zcsxll/zx_solder_paste_elf/README.md

# zx_solder_paste_elf

bilibili：https://www.bilibili.com/video/BV16M411r7NK/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

硬件设计参考了工科男孙老师的
https://www.bilibili.com/video/BV1Fd4y1F7oQ/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

感谢孙老师！

详细说明 --> 说明.docx
