zcsxll/zx_solder_paste_elf/说明.docx

目录

## 致谢

硬件设计参考了工科男孙老师的

https://www.bilibili.com/video/BV1Fd4y1F7oQ/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

感谢孙老师！

使用了同款N20电机，锂电池充放电方案和电机驱动方案也一样。

主要区别是单片机使用STM32，固定锡膏针筒使用PCB组成的卡扣。

# 硬件

## 开发环境

立创EDA标准版

## 文件说明

PCB_solder_paste_elf.json PCB文件

solder_paste_elf.json 原理图

stents_35g_1.json 卡扣（需要根据自己的锡膏尺寸修改，我用的是35g的）

stents_35g_2.json 同上

## 螺丝

用了两种。

固定N20和卡扣，使用的是M1.6，长度4毫米，略长~

另外一种是M3螺丝和铜柱，长度需要根据锡膏容量选择，因为上述N20电机的丝杆长度是固定的

## 垫片

用的是如下图：

5*3.2*3的意思是外直径5毫米，内直径3.2毫米，高度3毫米

# 软件

## 开发环境

Keil 5.27和cubeMX。

控制电机使用了2个通道的PWM，读取电机的编码器使用了STM32定时器的Encoder模式。电机转动的圈数采用位置式PID控制，PID参数没有细调，整个系统不需要特别精确。

# 卡扣安装

一共两种卡扣PCB，卡扣A（下图左）和卡扣B（下图右）。

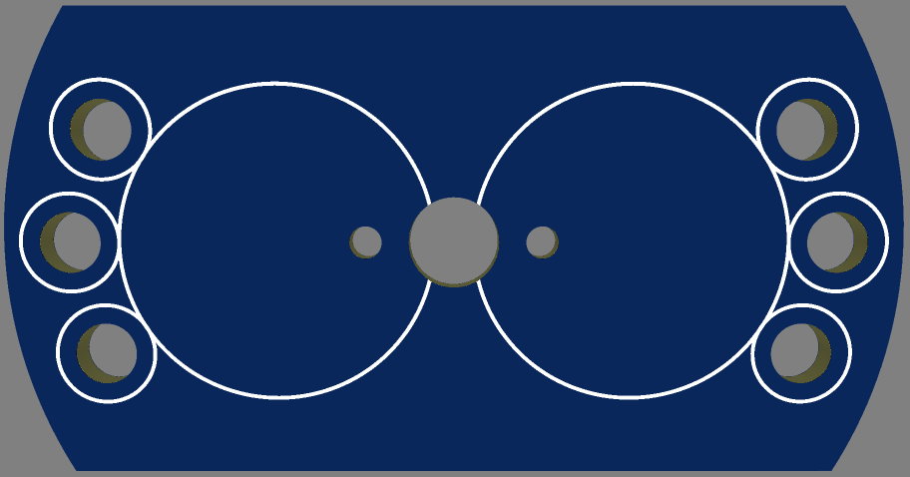
[picture p1: figure]
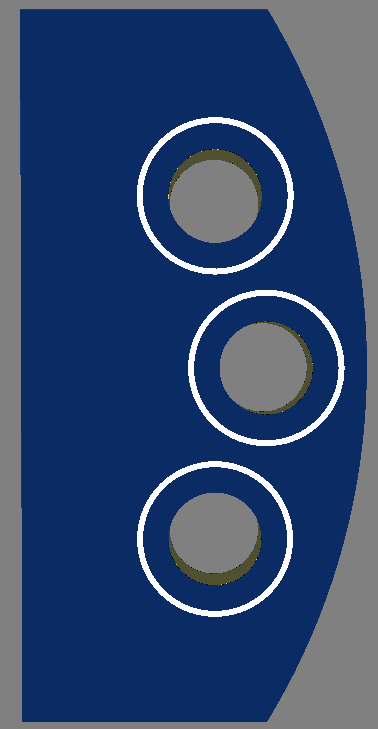
[picture p2: figure]

1. 固定N20电机和卡扣A，使用两个M1.6*3螺丝，两个螺丝孔如下图所指

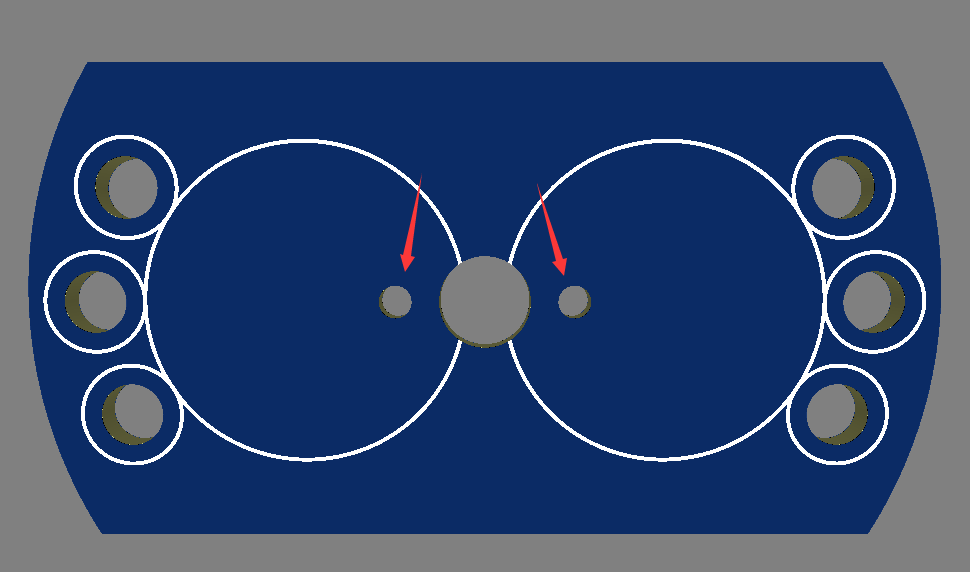
[picture p3: figure]
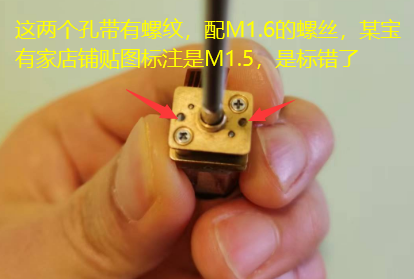
[picture p4: figure]

2. 根据丝杆长度以及锡膏容量的关系，选择6个合适长度的双通M3铜柱，做下图位置的连接。

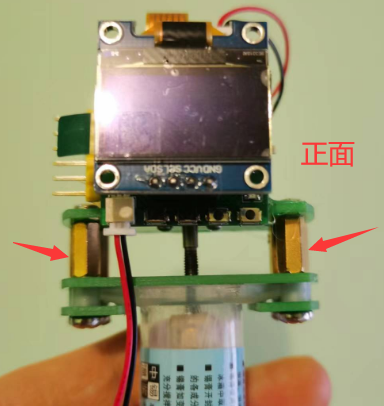
[picture p5: figure]
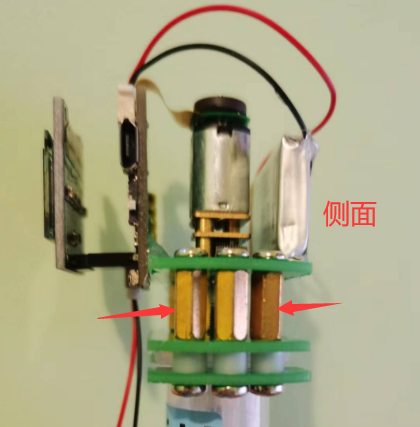
[picture p6: figure]

3. 使用6个5*3.2*3的垫片和6个M3螺丝，固定卡扣B，如下图红框中的部分

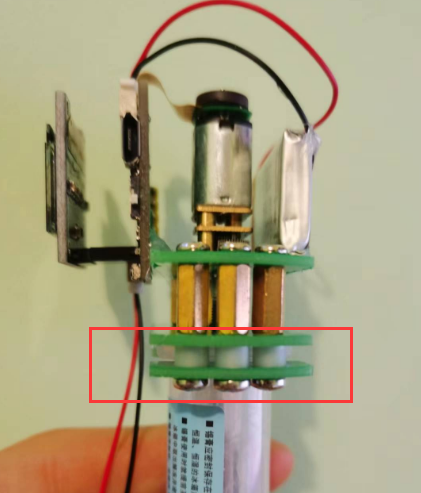
[picture p7: figure]
