zcsxll/zx_solder_paste_elf/(list of files, drawings)

Other design files:
hardware/PCB_solder_paste_elf.json
