zcsxll/zx_solder_paste_elf/software/STM32F042F6P6/Core/Src/main.c

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
/* Includes ------------------------------------------------------------------*/
#include "main.h"
#include "i2c.h"
#include "tim.h"
#include "gpio.h"

/* USER CODE BEGIN Includes */

#include <stdio.h>
#include "pos_pid.h"
#include "oled_096.h"

/* USER CODE END Includes */


/* USER CODE BEGIN PV */

uint8_t mode = 0;
uint16_t target = 200;
uint16_t speed = 700;
uint8_t done = 1;

/* USER CODE END PV */

void SystemClock_Config(void);
/* USER CODE BEGIN 0 */

#define PA0_SET	GPIOA->BSRR = GPIO_PIN_0
#define PA0_CLR	GPIOA->BRR = GPIO_PIN_0

/*int fputc(int ch, FILE *f) {
    HAL_UART_Transmit(&huart2, (uint8_t*)&ch, 1, 10);
    return (ch);
}*/

void HAL_TIM_PeriodElapsedCallback(TIM_HandleTypeDef *htim) {
    int16_t count = (int16_t)htim3.Instance->CNT;
    int16_t out = pos_pid_update(count);
    if(out == 0) {
        htim2.Instance->CCR1 = 0;
        htim2.Instance->CCR2 = 0;
		HAL_TIM_Base_Stop_IT(&htim17);
		done = 1;
    } else {
        htim2.Instance->CCR1 = 1000 - out;
        htim2.Instance->CCR2 = 1000;
    }
    //printf("%d %d\r\n", count, out);
}

uint8_t read_key() {
    uint8_t ret = 0;
    if((GPIOA->IDR & GPIO_PIN_4) == 0) {
        ret |= 1;
    }
    if((GPIOA->IDR & GPIO_PIN_3) == 0) {
        ret |= 2;
    }
    if((GPIOA->IDR & GPIO_PIN_2) == 0) {
        ret |= 4;
    }
    if((GPIOA->IDR & GPIO_PIN_5) == 0) {
        ret |= 8;
    }
    return ret;
}

void show_target() {
	static char buf[16];
	sprintf(buf, "target: %4d", target);
	oled_paint_string(&hi2c1, 16, 4, buf);
}

void show_speed() {
	static char buf[16];
	sprintf(buf, " speed: %4d", speed);
	oled_paint_string(&hi2c1, 16, 4, buf);
}

void show_mode_info() {
    if(mode == 0) {
        oled_paint_hz(&hi2c1, 32 + 0, 2, 0);
        oled_paint_hz(&hi2c1, 32 + 16, 2, 1);
        oled_paint_hz(&hi2c1, 32 + 32, 2, 2);
        oled_paint_hz(&hi2c1, 32 + 48, 2, 3);
        show_target();
    } else if (mode == 1) {
        oled_paint_hz(&hi2c1, 32 + 0, 2, 4);
        oled_paint_hz(&hi2c1, 32 + 16, 2, 5);
        oled_paint_hz(&hi2c1, 32 + 32, 2, 2);
        oled_paint_hz(&hi2c1, 32 + 48, 2, 3);
        show_speed();
		oled_paint_string(&hi2c1, 72, 6, "     ");
    } else if (mode == 2) {
		oled_paint_hz(&hi2c1, 32 + 0, 2, 6);
        oled_paint_hz(&hi2c1, 32 + 16, 2, 7);
        oled_paint_hz(&hi2c1, 32 + 32, 2, 2);
        oled_paint_hz(&hi2c1, 32 + 48, 2, 3);
        show_speed();
		oled_paint_string(&hi2c1, 72, 6, "     ");
	}
}

void adjust_target_or_speed(uint8_t key) {
	if (mode == 0) {
		if (key == 2) {
			target = target < 2000 ? target + 100 : 2000;
		} else {
			target = target > 100 ? target - 100 : 100;
		}
		show_target();
	} else if (mode == 1 || mode == 2) {
		if (key == 2) {
			speed = speed < 800 ? speed + 50 : 800;
		} else {
			speed = speed > 300 ? speed - 50 : 300;
		}
		show_speed();
	}
}

/* USER CODE END 0 */

/**
  * @brief  The application entry point.
  * @retval int
  */
int main(void) {
    /* MCU Configuration--------------------------------------------------------*/

    /* Reset of all peripherals, Initializes the Flash interface and the Systick. */
    HAL_Init();

    /* Configure the system clock */
    SystemClock_Config();

    /* Initialize all configured peripherals */
    MX_GPIO_Init();
    MX_I2C1_Init();
    MX_TIM2_Init();
    MX_TIM3_Init();
    MX_TIM17_Init();
    /* Infinite loop */
    /* USER CODE BEGIN WHILE */
    //printf("hello solder paste elf\r\n");

    oled_init(&hi2c1);
    oled_clear(&hi2c1);

    oled_paint_string(&hi2c1, 8, 0, "solder paste v1");

    htim2.Instance->CCR1 = 0;
    htim2.Instance->CCR2 = 0;
    HAL_TIM_PWM_Start(&htim2, TIM_CHANNEL_1);
    HAL_TIM_PWM_Start(&htim2, TIM_CHANNEL_2);

    HAL_TIM_Encoder_Start(&htim3, TIM_CHANNEL_1 | TIM_CHANNEL_2);

    pos_pid_init(1, 0.05, 0.6, 800, 0);
    //pos_pid_set_target(3000);

    //htim2.Instance->CCR1 = 800;
    //htim2.Instance->CCR2 = 1000;

    uint8_t key_flag = 0;
    show_mode_info();
    while(1) {
        //int16_t count = (int16_t)htim3.Instance->CNT;
        //printf("%d\r\n", count);
        //printf("%x %x\r\n", a, b);
        uint8_t key = read_key();
        //oled_paint_char(&hi2c1, 0, 6, '0' + key);
        if(key == 1 && key_flag == 0) {
            key_flag = 10;
            mode = (mode + 1) % 3;
            show_mode_info();
		} else if (key == 2 || key == 4) {
			if (key_flag == 0 || key_flag > 7) {
				adjust_target_or_speed(key);
			}
			key_flag ++;
		} else if (key == 8) {
			if (mode == 0) {
				if (key_flag == 0 && done == 1) {
					key_flag = 10;
					done = 0;
					htim3.Instance->CNT = 0;
					pos_pid_set_target(target);
					HAL_TIM_Base_Start_IT(&htim17);
				}
			} else if (mode == 1) {
				htim2.Instance->CCR1 = 1000 - speed;
				htim2.Instance->CCR2 = 1000;
				while (read_key() == 8) {
					HAL_Delay(10);
				}
				htim2.Instance->CCR1 = 0;
				htim2.Instance->CCR2 = 0;
			} else if (mode == 2) {
				htim2.Instance->CCR1 = 1000;
				htim2.Instance->CCR2 = 1000 - speed;
				while (read_key() == 8) {
					HAL_Delay(10);
				}
				htim2.Instance->CCR1 = 0;
				htim2.Instance->CCR2 = 0;
			}
        } else if(key == 0) {
            key_flag = 0;
        }
		
		char buf[32];
		if (mode == 0) {
			int16_t count = (int16_t)htim3.Instance->CNT;
			sprintf(buf, "%5d", count);
			oled_paint_string(&hi2c1, 72, 6, buf);
		}
			
        HAL_Delay(100);
        /* USER CODE END WHILE */

        /* USER CODE BEGIN 3 */
    }
    /* USER CODE END 3 */
}

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
