zcsxll/zx_solder_paste_elf/software/STM32F042F6P6/STM32F042F6P6.ioc

Mcu.UserName=STM32F042F6Px
PA0.Signal=S_TIM2_CH1_ETR
PA1.Signal=S_TIM2_CH2
PA10.Signal=I2C1_SDA
PA13.Signal=SYS_SWDIO
PA14.Signal=SYS_SWCLK
PA2.Signal=GPIO_Input
PA3.Signal=GPIO_Input
PA4.Signal=GPIO_Input
PA5.Signal=GPIO_Input
PA6.Signal=S_TIM3_CH1
PA7.Signal=S_TIM3_CH2
PA9.Signal=I2C1_SCL
