zcsxll/zx_solder_paste_elf/(notices)

Notices in the files:
software/STM32F042F6P6/Core/Src/main.c:
Copyright (c) 2022 STMicroelectronics.
All rights reserved.
This software is licensed under terms that can be found in the LICENSE file
